yutong526/therapy-haptic-wearable/analysis_out/A_pump_pressure_participantA.png

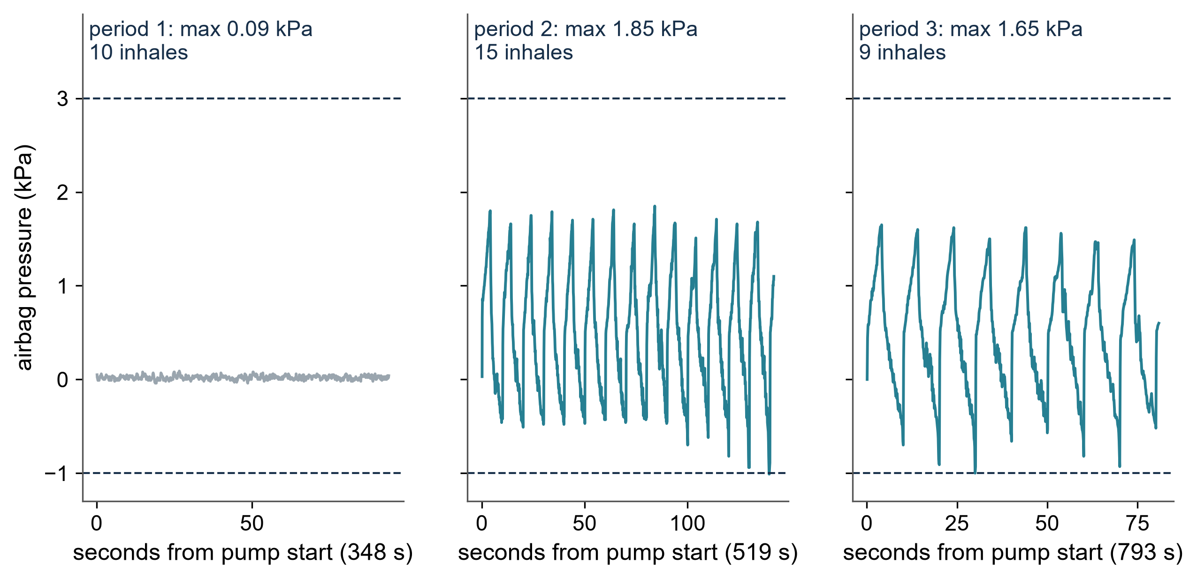
analysis_out/A_pump_pressure_participantA.png
