yutong526/therapy-haptic-wearable/analysis_out/B_breathing_cycle_participantB.png

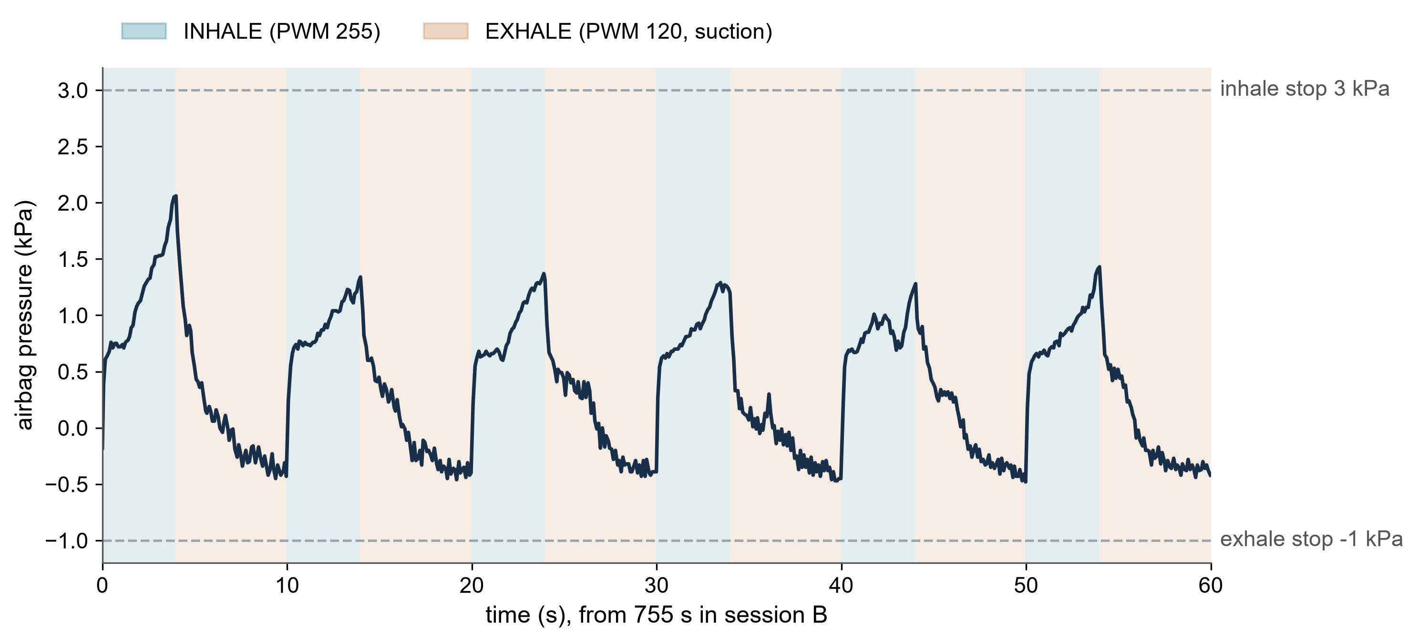
analysis_out/B_breathing_cycle_participantB.png
