yutong526/therapy-haptic-wearable/analysis_out/D_eda_after_pump_start.png

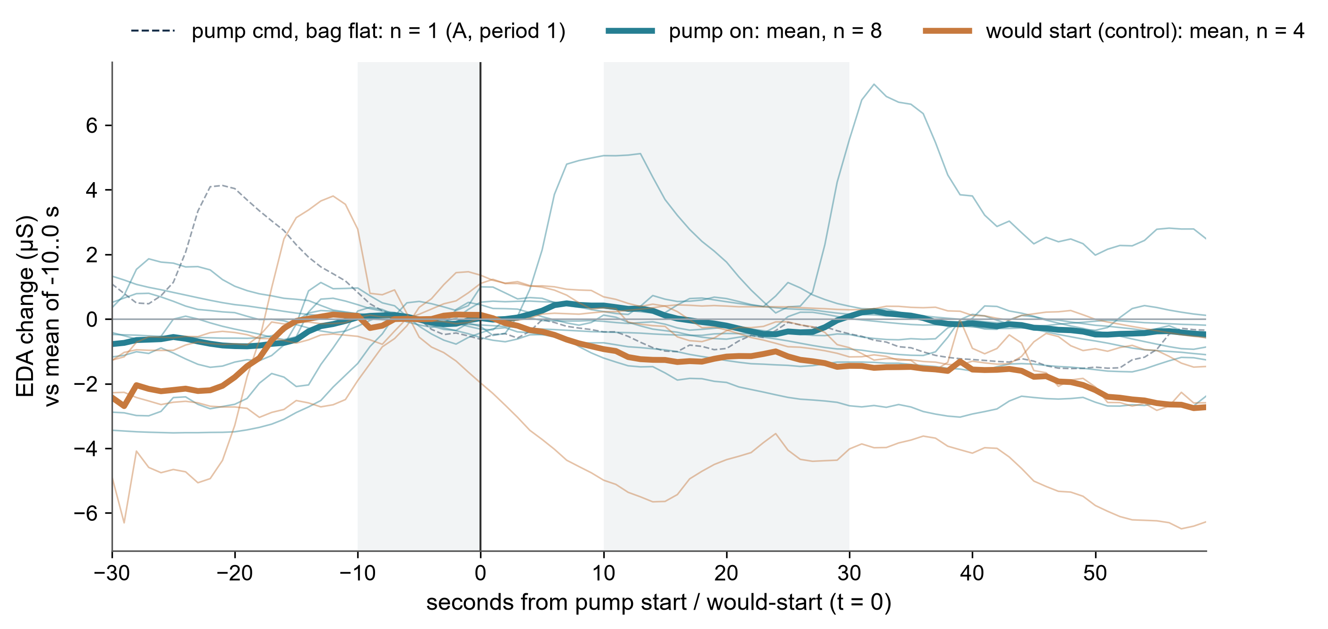
analysis_out/D_eda_after_pump_start.png
