yutong526/therapy-haptic-wearable/sessions/20261030_E/replay_soft_smooth_gated_chat.png

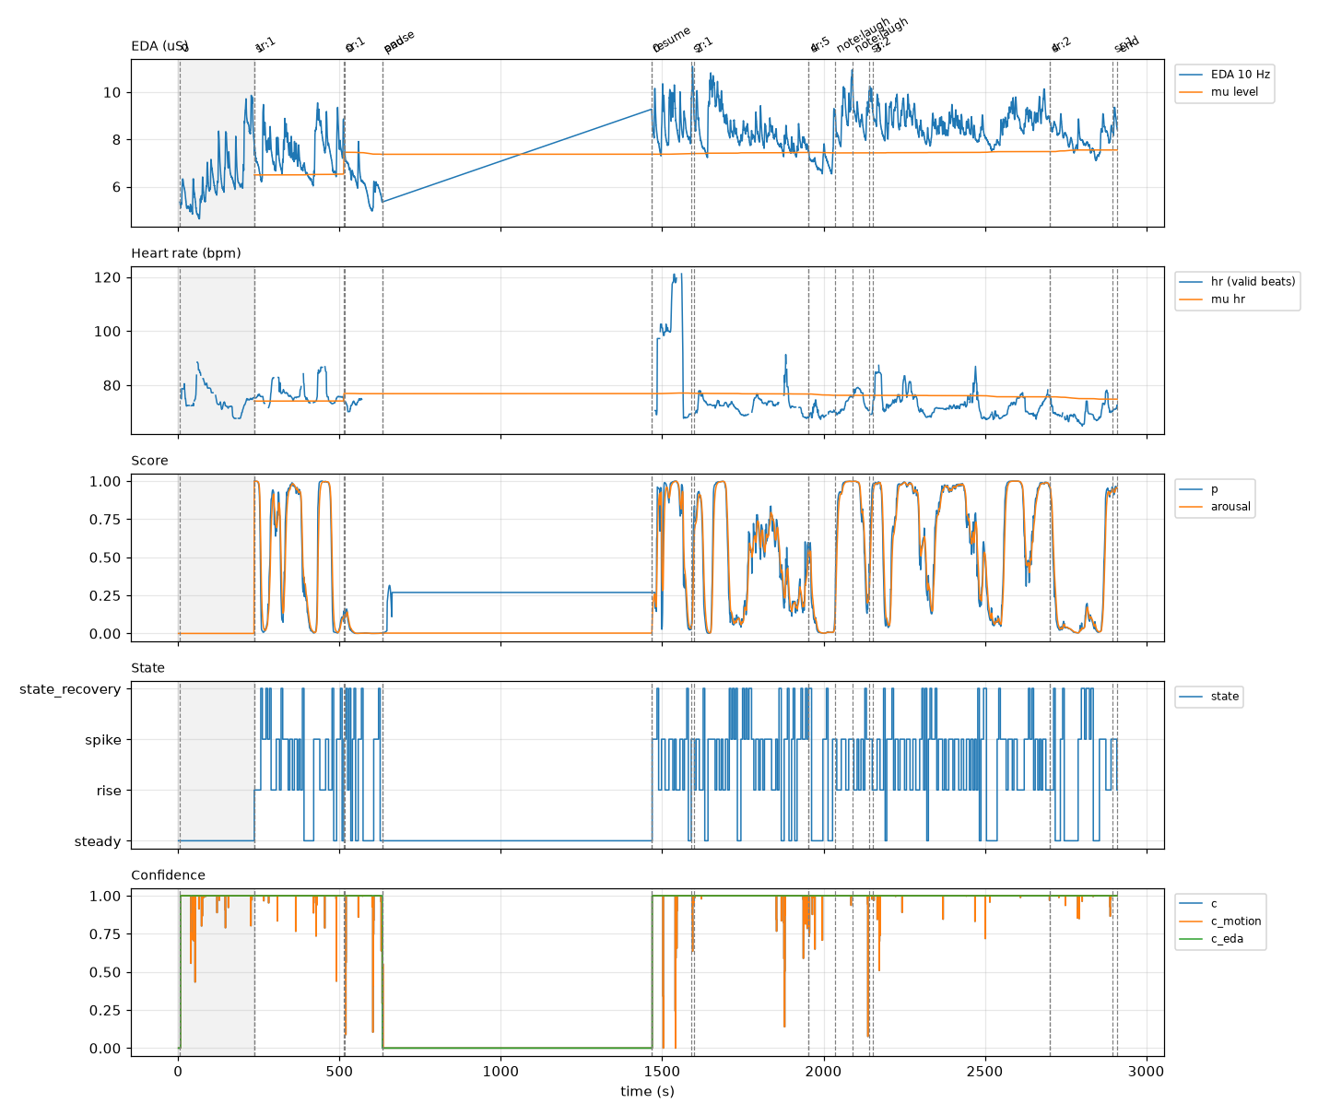
sessions/20261030_E/replay_soft_smooth_gated_chat.png
