yutong526/therapy-haptic-wearable/sessions/20261105_A/control_overview.png

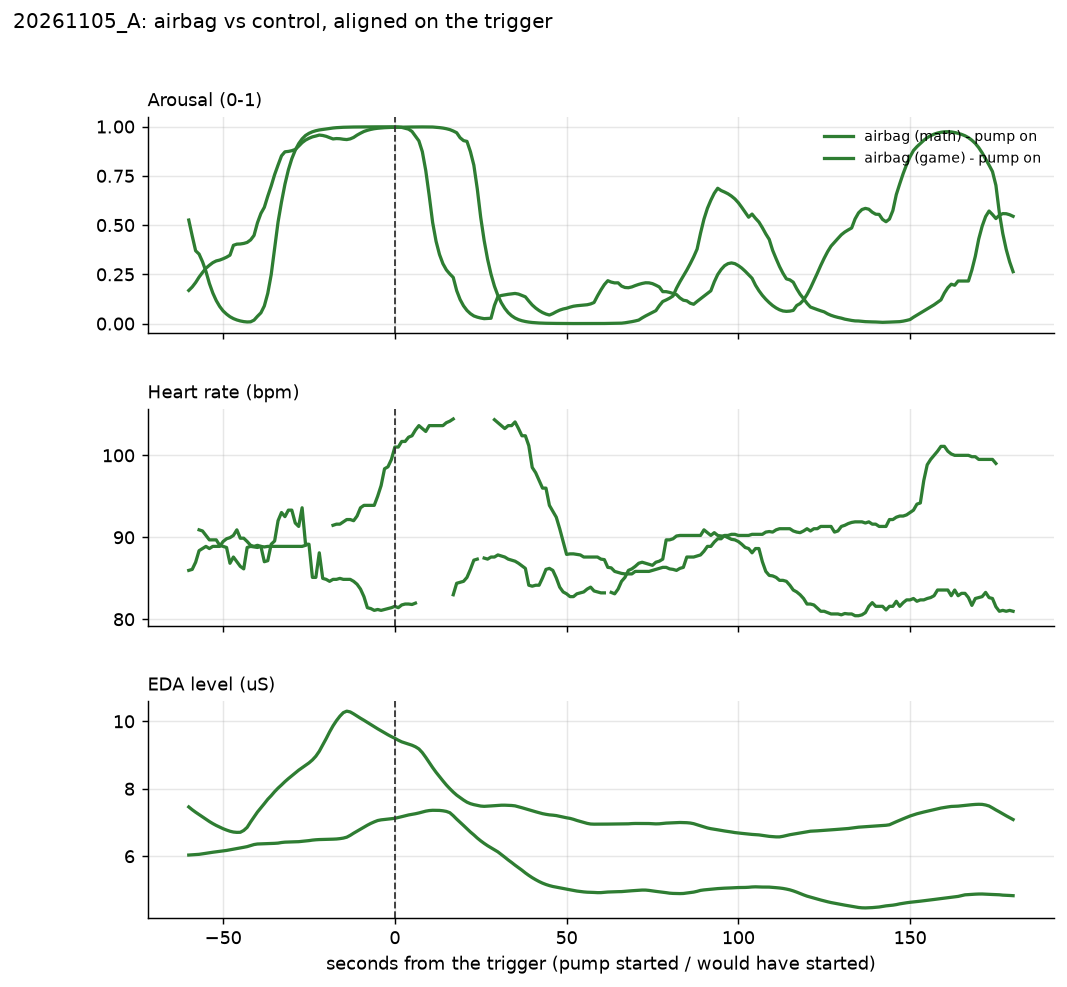
sessions/20261105_A/control_overview.png
