yutong526/therapy-haptic-wearable/sessions/20261105_B/control_overview.png

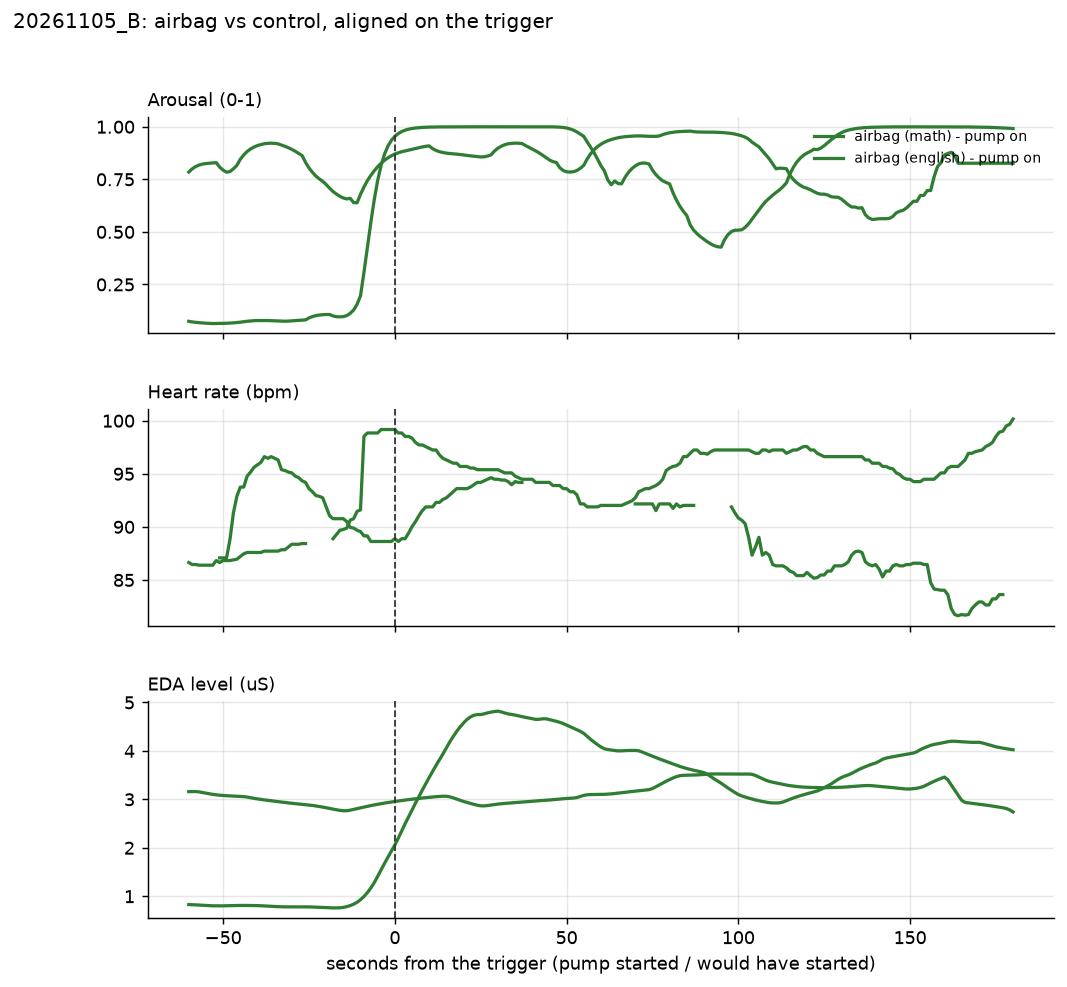
sessions/20261105_B/control_overview.png
