yutong526/therapy-haptic-wearable/sessions/20261105_C_3/control_overview.png

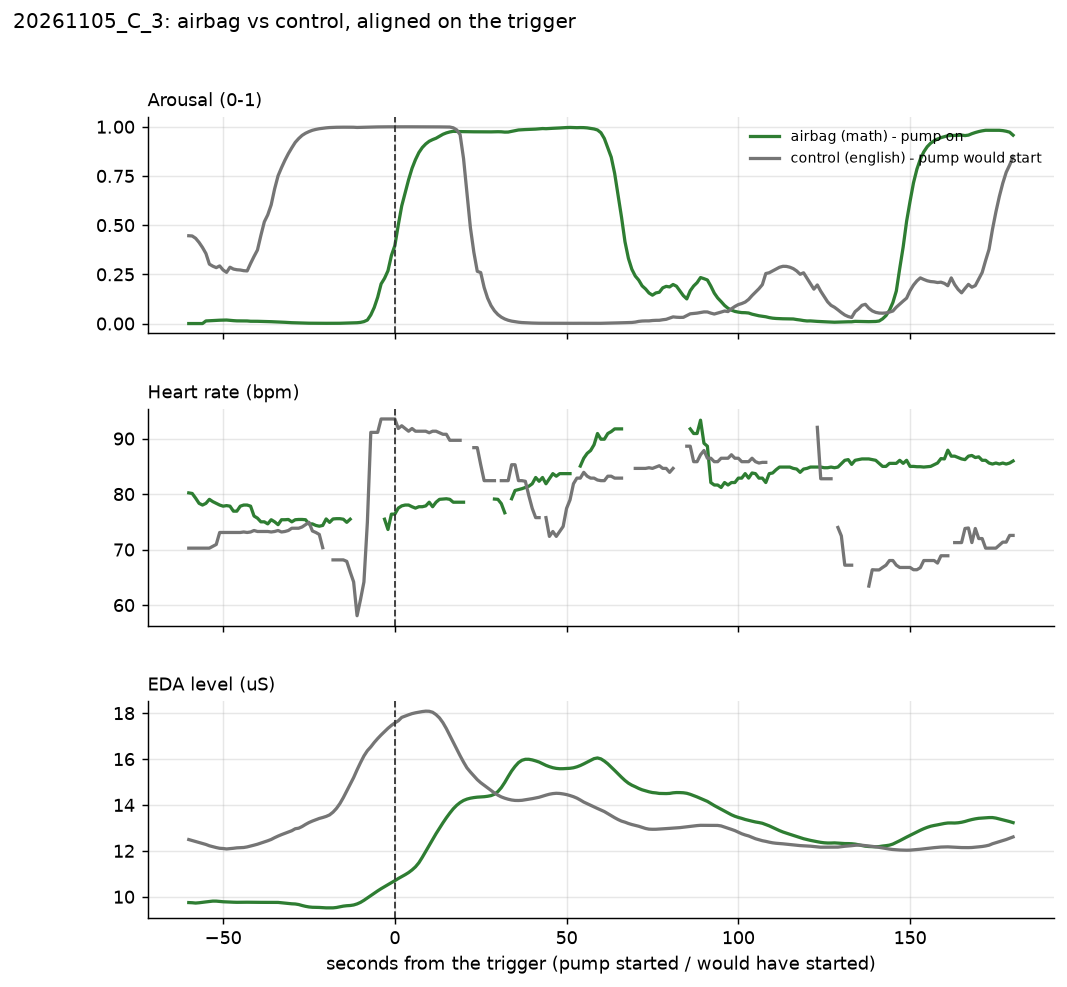
sessions/20261105_C_3/control_overview.png
