yutong526/therapy-haptic-wearable/sessions/20261105_D/control_overview.png

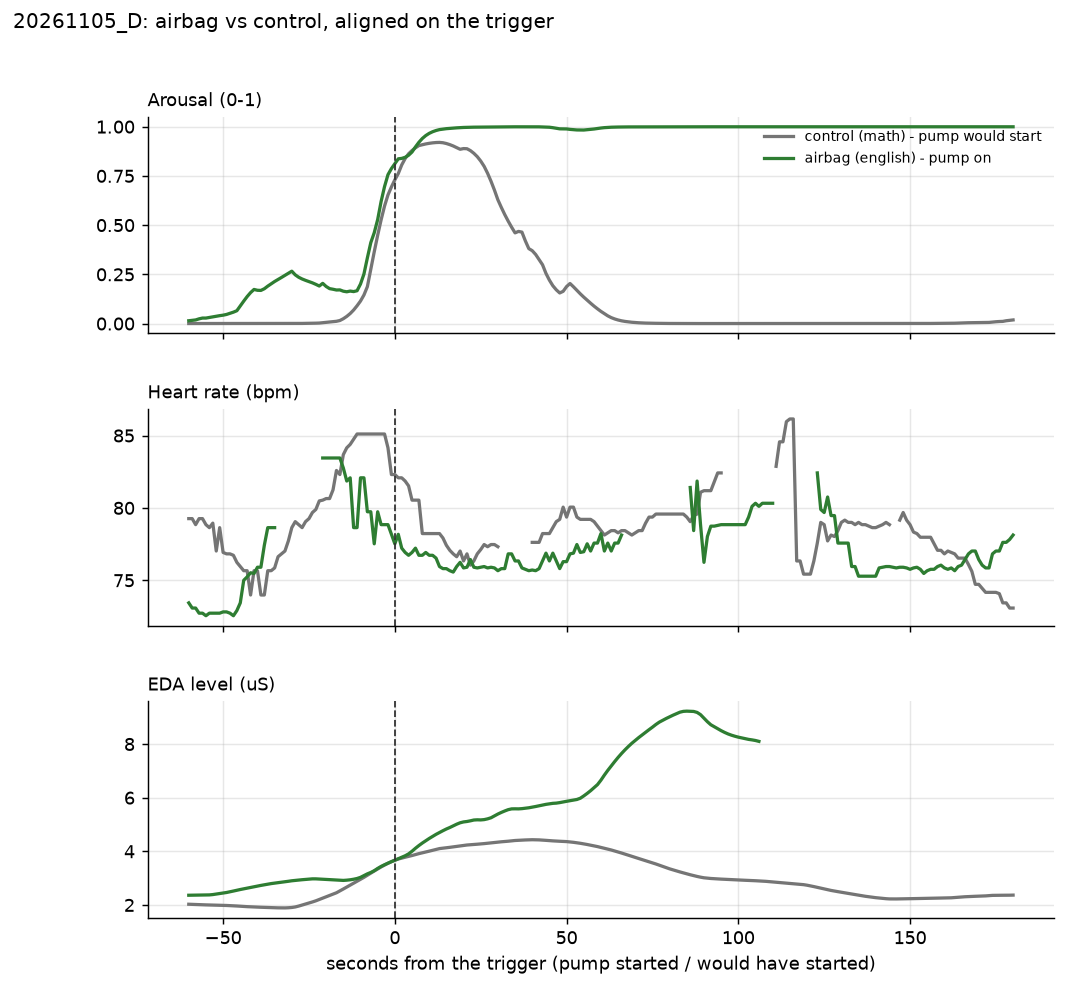
sessions/20261105_D/control_overview.png
