yutong526/therapy-haptic-wearable/analysis_out/E_steps_participantE.png

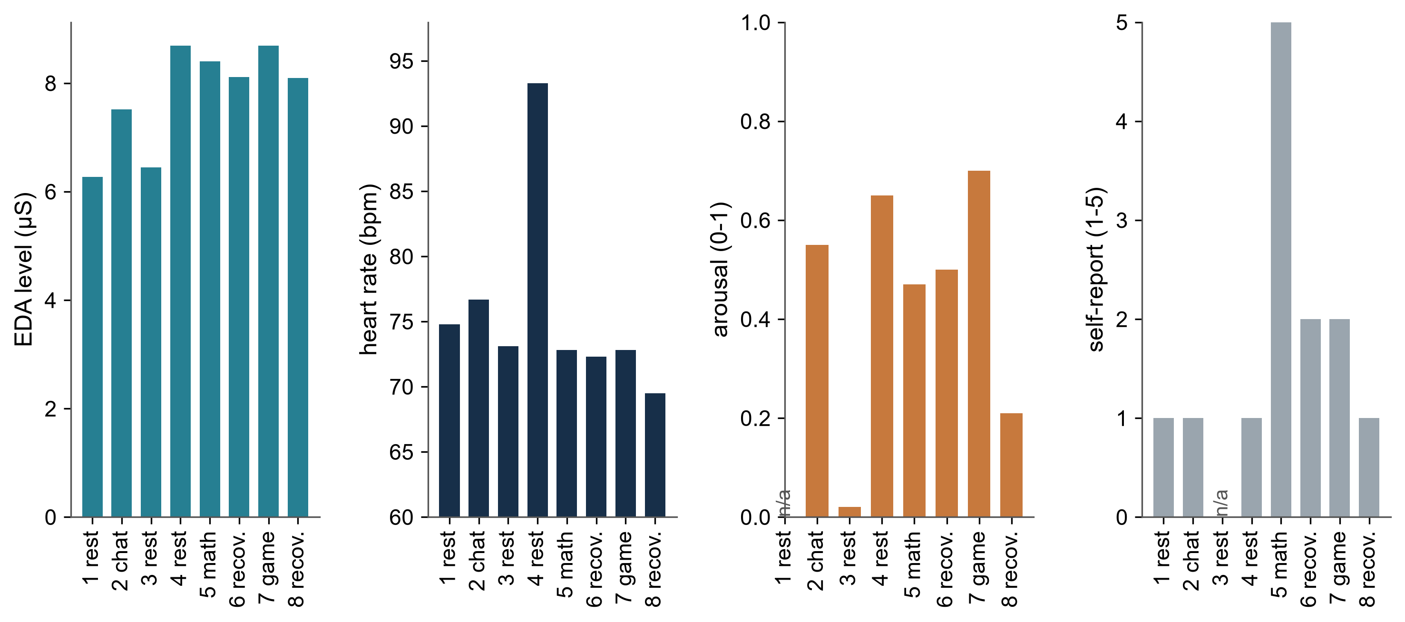
analysis_out/E_steps_participantE.png
