yutong526/therapy-haptic-wearable/analysis_out/results.md

# Presentation numbers (analysis_out)

Generated by `analysis_out/make_figures.py` from `sessions/` (read only). Times are seconds from the start of the recording. Descriptive only: few sessions, no tests of an effect.

## A. Participant A pump check (session 20261105_A, demo)

Source: `esp32_log.csv` (P lines: pressure every 0.1 s while on, 1 s while idle; F lines: phase changes) and `pump.csv`. Figure `A_pump_pressure_participantA.png`, table `A_pump_periods_participantA.csv`.

| period | on (s) | off (s) | on for (s) | max kPa | min kPa | INHALE phases | PWM in INHALE | DEFLATE took (s) | bag inflated |
|---|---|---|---|---|---|---|---|---|---|
| 1 | 348 | 442 | 94 | 0.09 | -0.04 | 10 | 255 | 20.0 | no |
| 2 | 519 | 661 | 142 | 1.85 | -1.01 | 15 | 255 | 1.2 | yes |
| 3 | 793 | 874 | 81 | 1.65 | -1.0 | 9 | 255 | 0.3 | yes |

- Board header lines (`# mode ...`) at t = [2, 348, 519, 793] s: every pump start re-sent the same setup (mode breathing, inhale PWM 255 to 3 kPa, exhale PWM 120 to -1 kPa, max 8 kPa, motors on). No fault lines, no restart and no `ERR`/safety message in the log.
- Markers: 60 s `1`, 211 s `5`, 298 s `note:math`, 463 s `pump:auto`, 634 s `note:end`, 774 s `note:game`, 1081 s `note:end`, 1157 s `end`.

## B. Breathing cycle (session 20261105_B)

Figure `B_breathing_cycle_participantB.png`: 60 s of P-line pressure from 755 s (3rd inhale of the longest pump-on period, 735-954 s). Shading from the F lines. All cycles: `B_cycles_participantB.csv`.

All complete cycles in B's 5 pump-on periods, n = 58 cycles (a cycle = INHALE start to the next INHALE start; the last, cut-off cycle of each period is left out):

- cycle length: mean 10.00 s (SD 0.00, range 10.00-10.00) → 6.0 breaths/min; inhale phase 4.00 s
- peak pressure per cycle: mean 1.51 kPa (SD 0.38, range 0.66-2.13); cycles reaching 3 kPa: 0 of 58
- minimum pressure per cycle: mean -0.56 kPa (SD 0.25, range -1.05--0.32); cycles reaching -1 kPa: 11 of 58
- the 60 s shown: n = 6 cycles, peak 1.46 kPa, minimum -0.46 kPa

## C. Pump decisions (4 closed-loop sessions)

Phases from the notes: `task (x)` = from `note:x` to `note:end`; `rest after x` = from that `note:end` to the next task note (or the end). Tables `C_pump_decisions.csv`, `C_would_on_control.csv`.

| session | type | # | start (s) | phase at start | start reason | on for (s) | stop reason | max kPa |
|---|---|---|---|---|---|---|---|---|
| A | demo | 1 | 348 | task (math) | rise for 30 s | 94 | steady / state_recovery for 30 s | 0.09 |
| A | demo | 2 | 519 | task (math) | rise for 30 s | 142 | steady / state_recovery for 30 s | 1.85 |
| A | demo | 3 | 793 | task (game) | rise for 30 s | 81 | steady / state_recovery for 30 s | 1.65 |
| B | demo | 1 | 302 | task (math) | spike for 15 s | 105 | steady / state_recovery for 30 s | 2.13 |
| B | demo | 2 | 467 | task (math) | rise for 53 s | 60 | steady / state_recovery for 32 s | 2.06 |
| B | demo | 3 | 587 | task (math) | spike for 47 s | 88 | steady / state_recovery for 30 s | 2.11 |
| B | demo | 4 | 735 | rest after math | rise for 38 s | 219 | steady / state_recovery for 30 s | 2.06 |
| B | demo | 5 | 1033 | task (english) | rise for 15 s | 146 | steady / state_recovery for 30 s | 1.18 |
| C_3 | control test | 1 | 387 | task (math) | rise for 15 s | 300 | maximum 300 s on | 2.61 |
| D | control test | 1 | 785 | task (english) | rise for 15 s | 279 | end of session | 1.76 |

- Real pump starts: n = 10 over 4 sessions; during a task: 9, during rest: 1.
  - 20261105_A: 3 starts (3 task, 0 rest)
  - 20261105_B: 5 starts (4 task, 1 rest)
  - 20261105_C_3: 1 starts (1 task, 0 rest)
  - 20261105_D: 1 starts (1 task, 0 rest)
- Stop reasons: steady / state_recovery for 30 s: 7, steady / state_recovery for 32 s: 1, maximum 300 s on: 1, end of session: 1.

Control blocks (rule ran, pump not allowed; logged as `would_on`):

| session | order | would start at (s) | phase | reason |
|---|---|---|---|---|
| C_3 | airbag_math | 747 | task (english) | rise for 29 s |
| C_3 | airbag_math | 998 | task (english) | spike for 15 s |
| C_3 | airbag_math | 1279 | rest after english | spike for 28 s |
| D | airbag_english | 547 | task (math) | rise for 15 s |

## D. EDA around pump start (raw EDA, 1-s means of `eda.csv`)

Each event: EDA from -30 to +60 s, minus its own mean of -10..0 s (shaded windows: -10..0 s and +10..+30 s). Figure `D_eda_after_pump_start.png`, table `D_eda_after_start.csv`.

- Excluded: D pump start at 785 s (English = airbag block). The BITalino battery died; EDA and ACC are invalid from about 878 s to the end (the `battery dead` note at 986 s was typed later). D's English block is left out of this task and of any airbag-vs-control comparison; D's math (control) would-start is kept (EDA before 878 s).

| session | t (s) | group | EDA -10..0 s (µS) | EDA +10..+30 s (µS) | change (µS) | largest rise 0-60 s (µS) | valid share |
|---|---|---|---|---|---|---|---|
| A | 348 | pump cmd, bag flat | 8.013 | 7.429 | -0.584 | -0.021 | 1.0 |
| A | 519 | pump on | 6.855 | 6.564 | -0.291 | 0.113 | 1.0 |
| A | 793 | pump on | 7.592 | 5.619 | -1.973 | -0.268 | 0.98 |
| B | 302 | pump on | 4.23 | 4.796 | 0.565 | 1.131 | 1.0 |
| B | 467 | pump on | 4.313 | 3.138 | -1.174 | -0.48 | 1.0 |
| B | 587 | pump on | 4.315 | 3.827 | -0.489 | 0.441 | 0.94 |
| B | 735 | pump on | 3.054 | 3.422 | 0.368 | 0.651 | 0.96 |
| B | 1033 | pump on | 3.199 | 2.906 | -0.293 | 0.417 | 1.0 |
| C_3 | 387 | pump on | 12.23 | 14.817 | 2.586 | 7.267 | 1.0 |
| C_3 | 747 | would start (control) | 18.689 | 14.015 | -4.674 | -1.977 | 0.99 |
| C_3 | 998 | would start (control) | 14.918 | 14.647 | -0.271 | 1.357 | 1.0 |
| C_3 | 1279 | would start (control) | 10.668 | 10.432 | -0.236 | 1.229 | 1.0 |
| D | 547 | would start (control) | 4.086 | 4.44 | 0.354 | 0.439 | 1.0 |

- pump cmd, bag flat: n = 1 events from 1 session(s) (A); change +10..+30 s minus -10..0 s: median -0.584 µS, mean -0.584 µS, range -0.584 to -0.584; 0 of 1 went up.
- pump on: n = 8 events from 3 session(s) (A, B, C_3); change +10..+30 s minus -10..0 s: median -0.292 µS, mean -0.088 µS, range -1.973 to +2.586; 3 of 8 went up.
- would start (control): n = 4 events from 2 session(s) (C_3, D); change +10..+30 s minus -10..0 s: median -0.254 µS, mean -1.207 µS, range -4.674 to +0.354; 1 of 4 went up.

## E. Participant E, ML data collection (session 20261030_E, n = 1 person)

From `features_labeled.csv` (offline replay `replay_soft_smooth_gated_chat.csv`, baseline from the chat step, labels from `make_labels.py`). Means over all labelled seconds of a step (EDA level = 30 s mean, HR = median of valid beats over 30 s). Figure `E_steps_participantE.png`, table `E_steps_participantE.csv`.

| step | condition | after | seconds (valid) | EDA (µS) | HR (bpm) | arousal | self-report | baseline s |
|---|---|---|---|---|---|---|---|---|
| 1 | rest |  | 230 (0) | 6.27 | 74.8 |  | 1 | 0 |
| 2 | chat | rest | 277 (277) | 7.52 | 76.7 | 0.55 | 1 | 213 |
| 3 | rest | chat | 118 (116) | 6.45 | 73.1 | 0.02 |  | 0 |
| 4 | rest | rest | 125 (120) | 8.69 | 93.3 | 0.65 | 1 | 0 |
| 5 | math | rest | 357 (356) | 8.4 | 72.8 | 0.47 | 5 | 0 |
| 6 | recovery | math | 188 (187) | 8.11 | 72.3 | 0.5 | 2 | 0 |
| 7 | game | recovery | 550 (550) | 8.69 | 72.8 | 0.7 | 2 | 0 |
| 8 | recovery | game | 194 (194) | 8.1 | 69.5 | 0.21 | 1 | 0 |

---

# Caveats and explanations (read with the sections above)

## A. Why A period 1 looks flat
- What the log shows: the start command arrived (setup header at 348 s, mode `breathing`, `motors on`), the
  board ran the normal phase sequence (10 INHALE / EXHALE phases of 4 s / 6 s, F lines) and drove the inflate
  pump at PWM 255 in every INHALE (P lines). The pressure still stayed at 0.0 kPa (max 0.09, min -0.04).
- At the stop (442 s) DEFLATE ran its full 20 s timeout (442-462 s), because the pressure never reached -1 kPa.
  Periods 2 and 3 ended DEFLATE in 1.2 s and 0.3 s.
- No fault, safety stop, restart or range error is logged. Same setup and same zero offset (0.61 kPa) in all three
  starts, so it is not a mode or setting difference.
- So the board commanded the pump but no air reached the sensor / bag: most likely a physical cause (tube not
  connected, or the pump's motor supply off). The log cannot tell which. A `pump:auto` marker at 463 s (the Auto
  button pressed right after that DEFLATE) suggests the operator noticed something; from period 2 on (519 s) the
  bag inflated normally.
- A's starts say "rise for 30 s": that session ran before the start rule was shortened to 15 s.

## B. Pressure
- The 3 kPa inhale target was never reached (0 of 58 cycles in B); the inhale phase always ran its full 4 s
  at PWM 255, so the bag on the body peaks at about 1.5 kPa. Cycle length is fixed by the firmware timer
  (4 s + 6 s = 10 s, 6 breaths/min), not by the pressure.

## C. Notes
- A period 1 is counted as a start although the bag did not inflate (see A).
- D: the pump stayed on 279 s until the end of the session, because the BITalino battery died (see D).
- 9 of the 10 starts fell during a task, 1 in a rest (B, 735 s, 2.5 min after math ended).
  4 sessions, 4 people; the demo sessions had no control block.

## D. Caveats
- D: the BITalino battery died; EDA and ACC are invalid from about 878 s (14.6 min) to the end (the
  `battery dead` note at 986 s was typed later). EDA from 878 s is treated as missing. **D's English (airbag)
  block is excluded from D and from any airbag-vs-control comparison.** Heart rate (RT7015) is valid for the whole
  session but is not used here. D's math (control) would-start at 547 s is kept.
- With D's airbag block excluded, only C_3 has both an airbag and a control block (1 pump start vs 3
  would-starts in one person). No paired airbag-vs-control comparison is possible.
- The rule starts the pump after EDA / arousal has risen, so EDA often falls afterwards on its own; the control
  would-starts are there to show this. Groups are small (8 vs 4 events, 3 vs 2 people), events within a person are
  not independent, and EDA levels differ a lot between people (hence the change from each event's own -10..0 s).
  Descriptive only.
- C_3's pump start (387 s) has the largest rise: +7.3 µS peak about 30 s after the start, during math.
- A period 1 (command sent, bag flat) is shown as a dashed line and kept out of both means.

## E. Caveats (E)
- One person, one session; the markers were corrected after the session (`markers_before_edit.csv` keeps the
  original).
- Step 1 (rest) came before the baseline (chat), so there is no arousal for it (0 valid seconds in the replay).
- Step 3 (rest) has no self-report: the recording stopped at 632 s, was paused about 14 min and resumed; step 4 is
  the rest after the resume. Its HR (93 bpm) and EDA are higher than in the other rests.
- The labels and the signals do not agree everywhere: math was rated 5 but has a mean arousal of 0.47; the game was
  rated 2 with the highest arousal (0.70).
  This is the kind of label noise that a learned model would have to handle.
- Arousal uses the hand-set default weights (not a learned model).

## F. Airbag test sessions (EDA at rest, before vs during the airbag)
- Found: `20261104_hwtest_wrist`, `20261104_hwtest_wrist_2`, `20261104_hwtest_wrist_3` (protocol
  `config/airbag_test.yaml`, site wrist). None can be used: `eda.csv` holds only the header (no EDA samples), there
  are no step markers (only `end` in `_3`), `pump.csv` is empty and the ESP32 log has no phase lines (the pump never
  ran). **F cannot be done: no airbag-at-rest data exists.**
- Also found: 18 folders `2026110x_*_pump_wrist` with only `pump_console.csv` (bench tests of the pump with
  `pump_console.py`, no physiological data).
- Not analysed, out of scope: `20261104_demo`, `_demo_2` ... `_demo_5`, `20261105_demo` (demo runs with pump
  events), `20261105_C`, `20261105_C_2` (earlier recordings of the same person before `C_3`), p00 / p01 / test
  sessions (data collection or development).

## Files
- `make_figures.py` re-creates everything: `.venv\Scripts\python analysis_out\make_figures.py` (writes
  `results_auto.md`; this file = that output + these notes).
- Figures: `A_pump_pressure_participantA.png`, `B_breathing_cycle_participantB.png`, `D_eda_after_pump_start.png`,
  `E_steps_participantE.png` (300 dpi, about 10 x 4.5 in). Tables: the `.csv` files with the same letters.
