yutong526/therapy-haptic-wearable/(commit log)

2026-10-22 EDA Sensor Code
    [eda.csv]
2026-10-23 EDA Update
    [eda.csv, eda_20261022_132911.csv, eda_20261022_155719.csv, eda_20261022_155928.csv, eda_20261022_160115.csv, eda_20261022_160249.csv, eda_20261022_160624.csv]
2026-10-26 Add ESP32-S3 firmware for MPU6050 IMU and RT7015 PPG
    - src/main.cpp: MPU6050 bring-up (raw I2C, gyro bias calibration), RT7015 AOUT/SOUT
    sampling at 100 Hz, adaptive-threshold heart-rate detection ported from rt7015_uno.ino,
    Teleplot / raw CSV output modes
    - tools/live_plot.py: live plot of PPG, heart rate and IMU, optionally together with the
    BITalino EDA recorder; can save both recordings
    - tools/serial_logger.py: log ESP32 serial output to CSV with UTC timestamps
    - rt7015_uno.ino: Arduino UNO reference version of the RT7015 reader
    - PlatformIO config and Python requirements
2026-10-28 Add live biofeedback input pipeline (EDA + PPG + motion)
    - BITalino EDA conversion per datasheet Rev B (uS = ADC/2^10 * 3.3 / 0.132)
    - biofeedback/: shared Processor for live, replay and simulation; features,
    confidence, baseline, scoring, state machine; all tunables in settings.py
    - Motion from the BITalino ACC (--acc-channel, calibrated) or the ESP32 IMU
    - tools: run_session, replay_session, make_labels, imu_check, acc_check
    - Session recording to per-stream CSVs; serial + UDP outputs
    - README with setup, common commands and architecture
2026-10-29 Read the RT7015 PPG over BLE; add testing protocol
    - biofeedback/ppg_ble.py: bleak source for the RT7015 (scan or fixed address,
    start/stop commands, reconnect), frame parser with bad-frame counting,
    sample clock from sample count anchored on receive times, beat detection
    on SOUT edges with an AOUT check; shared by live, simulation and replay
    - run_session: --ppg ble (default) / esp32 / none, --ppg-address; ESP32 optional
    - replay re-detects beats from ppg.csv; simulated RT7015 link with drift,
    jitter, broken frames and a link drop
    - tools/ppg_check.py: BLE PPG check on its own
    - PPG_MIN_PULSE_MV 500 -> 100 after the first recording (HR 8 % -> 91 % of the time)
    - docs/testing_process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
    [ppg_ble.py, replay.py, settings.py, sim.py]
2026-10-29 Live window, protocol file, chat baseline and cleanup
    - run_session.py --plot: live window with plots coloured by condition, protocol step
    countdown, marker / self-report / note buttons, sensor lights and an End button
    - config/protocol.yaml: test protocol (chat 4, rest 3, math / game 5, recovery 3 min),
    counterbalanced order by subject number; config/therapy.yaml for actual use
    - Baseline from the chat phase (first 60 s dropped, c >= 0.8), rest as an option;
    phases end at the self-report; replay --baseline-source chat|rest
    - make_labels.py: condition, phase_idx, after, sr and is_baseline columns
    - Motion only from the BITalino ACC; ESP32 kept as the output link only; removed the
    wir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
    [eda.csv, eda_20261022_132911.csv, eda_20261022_155719.csv, eda_20261022_155928.csv, eda_20261022_160115.csv, eda_20261022_160249.csv, eda_20261022_160624.csv]
2026-11-02 Beat detection on the AOUT wave, pause/resume, named sessions, first training scripts
    - Beats from AOUT pulse-wave peaks (PPG_BEAT_METHOD = "aout", vendor SOUT rule kept);
    HR kept 5 s after a valid beat, IBI limit 1333 ms. On recorded data HR availability
    rose from 41 % to 74 % (weak signal) and 92 % to 96 % (good signal)
    - Live window: Pause / Resume button; paused seconds are left out of labels and baseline
    - run_session.py --resume FOLDER continues a stopped session (state restored by replay,
    stopped time recorded as a pause); --name gives session folders <date>_<name>
    - Self-report entered within 60 s after the next code counts for the step before
    - tools/build_dataset.py and tools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
2026-11-04 Airbag pump integration: firmware, closed loop, demo window
    - firmware/pump: classic ESP32 DevKit pump firmware (USB + Bluetooth serial). Breathing assist is
    open loop (4 s inflate pump, 6 s deflate pump, pressure only stops a pump early); constant
    pressure uses a PI controller. Heartbeat, over-pressure, sensor and fill-timeout safety;
    deflation by suction. Replaces the old ESP32-S3 firmware.
    - run_session.py: pump link (--esp32, --pump protocol|auto|off), closed-loop PumpController,
    manual pump:inflate / breathe / off / auto, automatic protocol steps.
    - Live window: pump box (Inflate / Breathe / Deflate / Auto, board pressure, trigger progress,
    banner and beep on each change), scr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
    [esp32.py, live_window.py, protocol.py]
2026-11-04 Auto button: always gives feedback, starts the closed loop when run with --pump off; show who controls the pump
2026-11-05 Control test, notes in every mode, clearer pump feedback, relaxed start rule
    - Control test (config/control_test.yaml, control_test.bat): demo-like window, tasks marked by
    notes (note:math / note:english ... note:end); the closed loop may start the airbag in one task
    only, the other only logs would_on / would_off. The airbag task alternates over finished
    sessions (--order next). tools/analyze_control.py aligns both blocks on the (would-be) trigger.
    - Live window: note box in all modes; green banner and Auto button for automatic starts; strip
    under the plots marking when the pump was on; demo / therapy phase in light red.
    - Closed loop starts after 15 valid seconds of rise / spike (wa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
2026-11-09 Publish five pseudonymised sessions (A-E), pseudonyms in code and docs, presentation analysis
    [A_pump_periods_participantA.csv, B_cycles_participantB.csv, C_pump_decisions.csv, C_would_on_control.csv, D_eda_after_start.csv, E_steps_participantE.csv, acc.csv, beats.csv]
